devcafeine/buildbeacon/(list of files, cad)

Other CAD files:
hardware/cad/buildbeacon_tile_v1.0.scad
hardware/cad/buildbeacon_tile_v1.1.scad
hardware/cad/buildbeacon_tile_v1.2.scad
hardware/cad/buildbeacon_tile_v1.3.scad
hardware/cad/buildbeacon_tile_v1.4.scad
hardware/cad/buildbeacon_tile_v1.5.scad
hardware/cad/buildbeacon_tile_v1.6.scad
