devcafeine/buildbeacon/hardware/pcb/buildbeacon_master_v1.2.kicad_pcb

## KiCad design hardware/pcb/buildbeacon_master_v1.2.kicad_pcb (2026-11-11)

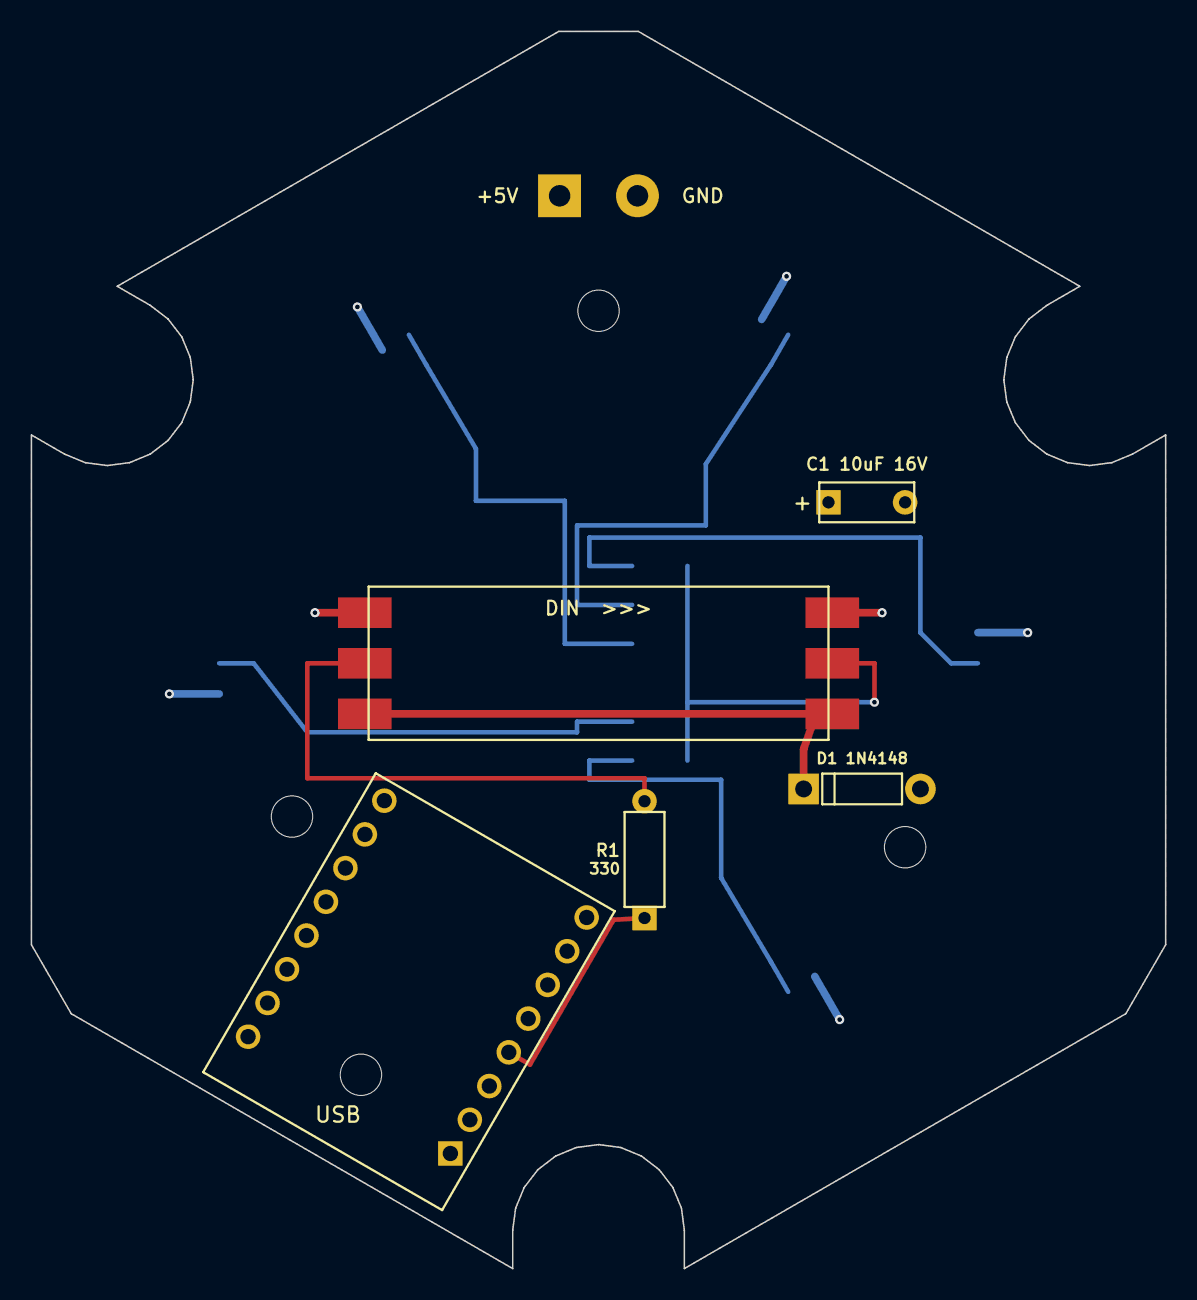
[picture p7: board buildbeacon_master_v1.2.kicad_pcb from above]

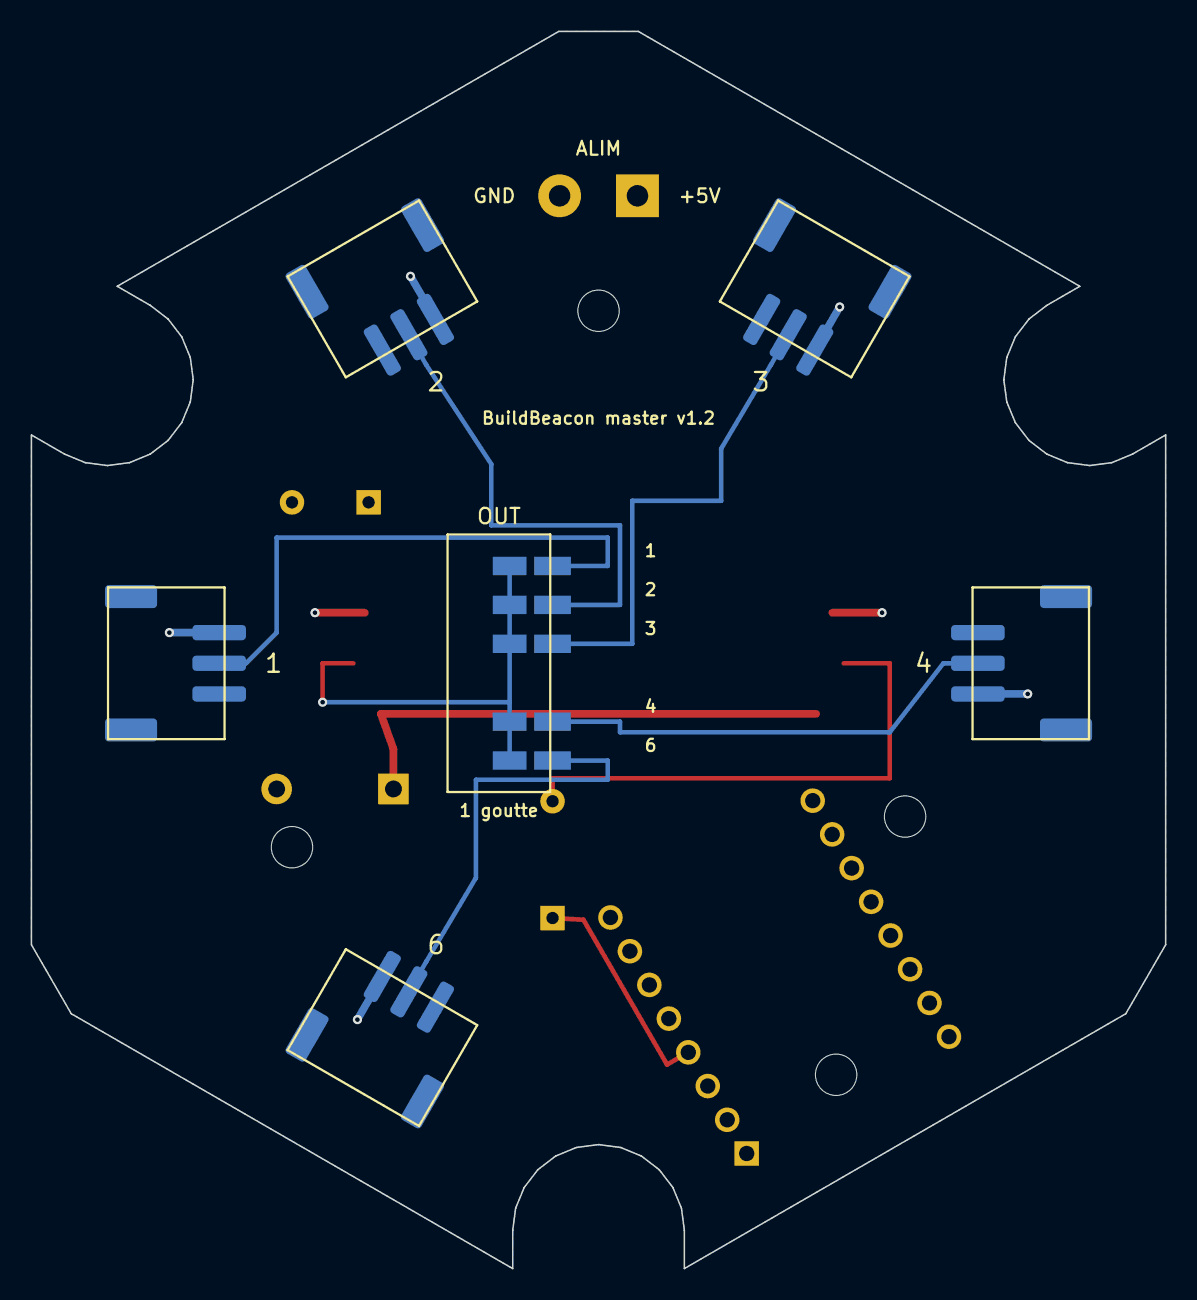
[picture p8: board buildbeacon_master_v1.2.kicad_pcb from below]

Board: 2 copper layers, 74.0 x 80.7 mm, 16 parts (6 on the bottom side), 11 nets.

Parts:
C1: 10uF; C_P5.00
D1: 1N4148/1N4007; D_DO-41_P7.62
H1, H2, H3, H4: M2.5; MountingHole_M2.5
J1, J2, J3, J4, J6: JST_PH_S3B-PH-SM4-TB_1x03-1MP_P2.00mm_Horizontal
J7: ALIM 5V; Alim_5V_P5.08
R1: 330; R_Axial_P7.62
RB1: Ruban_WS2812B_10mm
SW_OUT: SolderJumper_x5_P2.54
U1: ESP32-C3 SuperMini; ESP32-C3_SuperMini

Connections:
+5V: C1.1, D1.2, J1.1, J2.1, J3.1, J4.1, J6.1, J7.1, U1.L1
DO: RB1.OUT_D, SW_OUT.1B, SW_OUT.2B, SW_OUT.3B, SW_OUT.4B, SW_OUT.6B
GND: C1.2, J1.3, J1.MP, J2.3, J2.MP, J3.3, J3.MP, J4.3, J4.MP, J6.3, J6.MP, J7.2, RB1.IN_GND, RB1.OUT_GND, U1.L2
GPIO4: R1.1, U1.L4
S1_DIN: R1.2, RB1.IN_D
SIDE1: J1.2, SW_OUT.1S
SIDE2: J2.2, SW_OUT.2S
SIDE3: J3.2, SW_OUT.3S
SIDE4: J4.2, SW_OUT.4S
SIDE6: J6.2, SW_OUT.6S
VLED: D1.1, RB1.IN_5V, RB1.OUT_5V
