devcafeine/buildbeacon/hardware/pcb/buildbeacon_tuile_v1.2.kicad_pcb

## KiCad design hardware/pcb/buildbeacon_tuile_v1.2.kicad_pcb (2026-11-11)

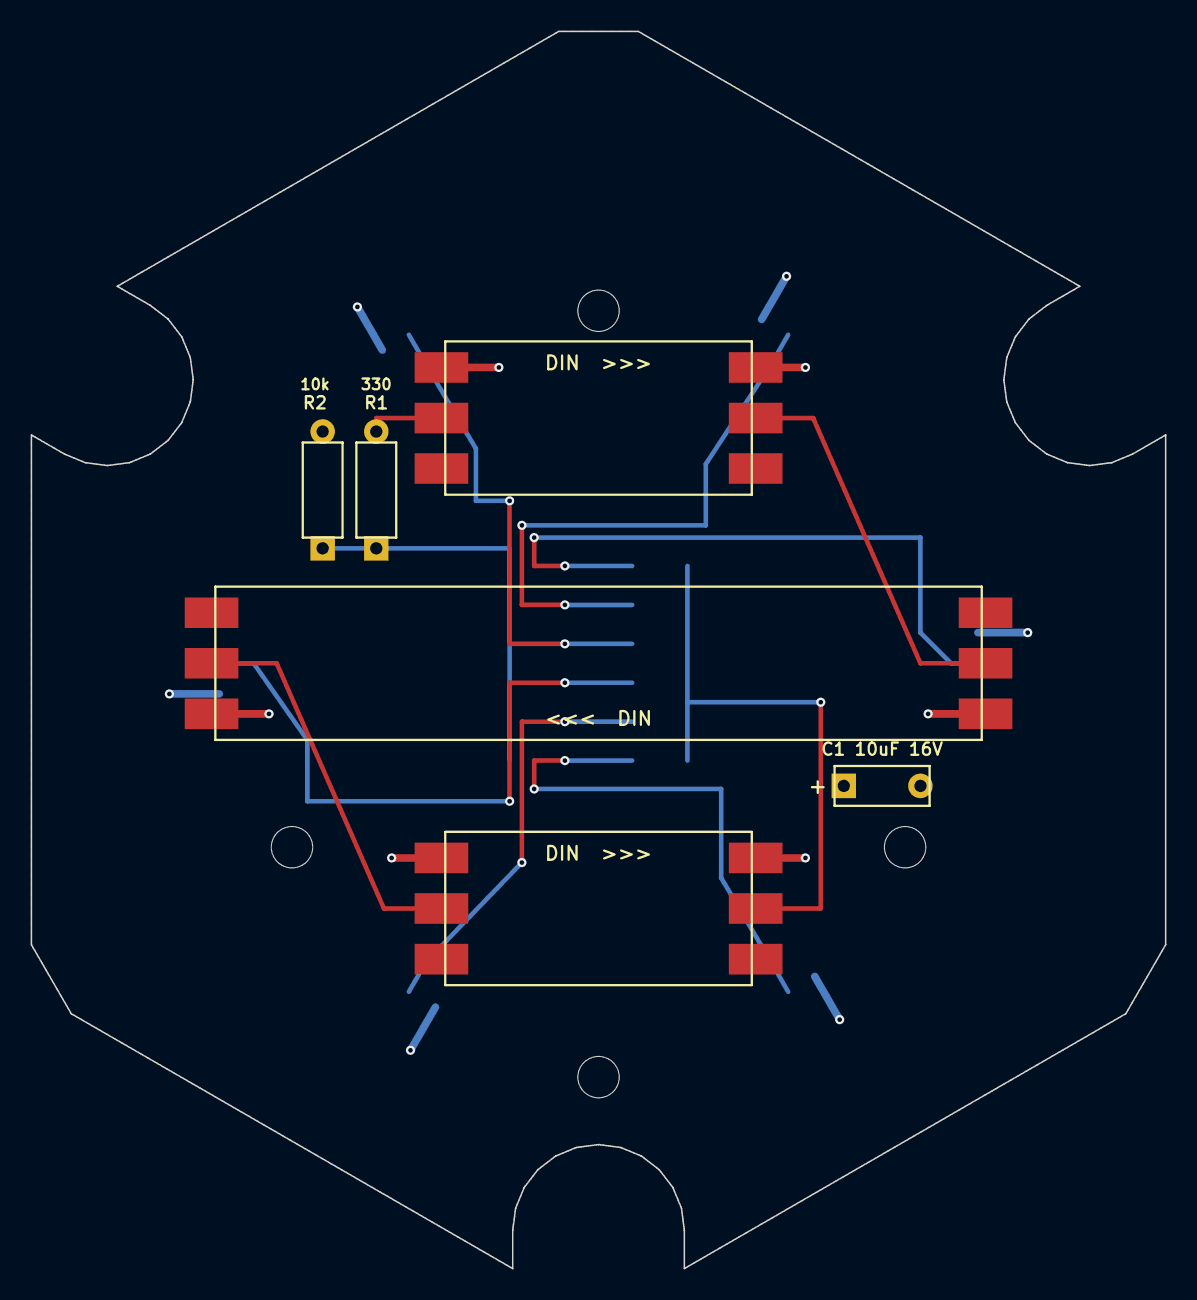
[picture p9: board buildbeacon_tuile_v1.2.kicad_pcb from above]

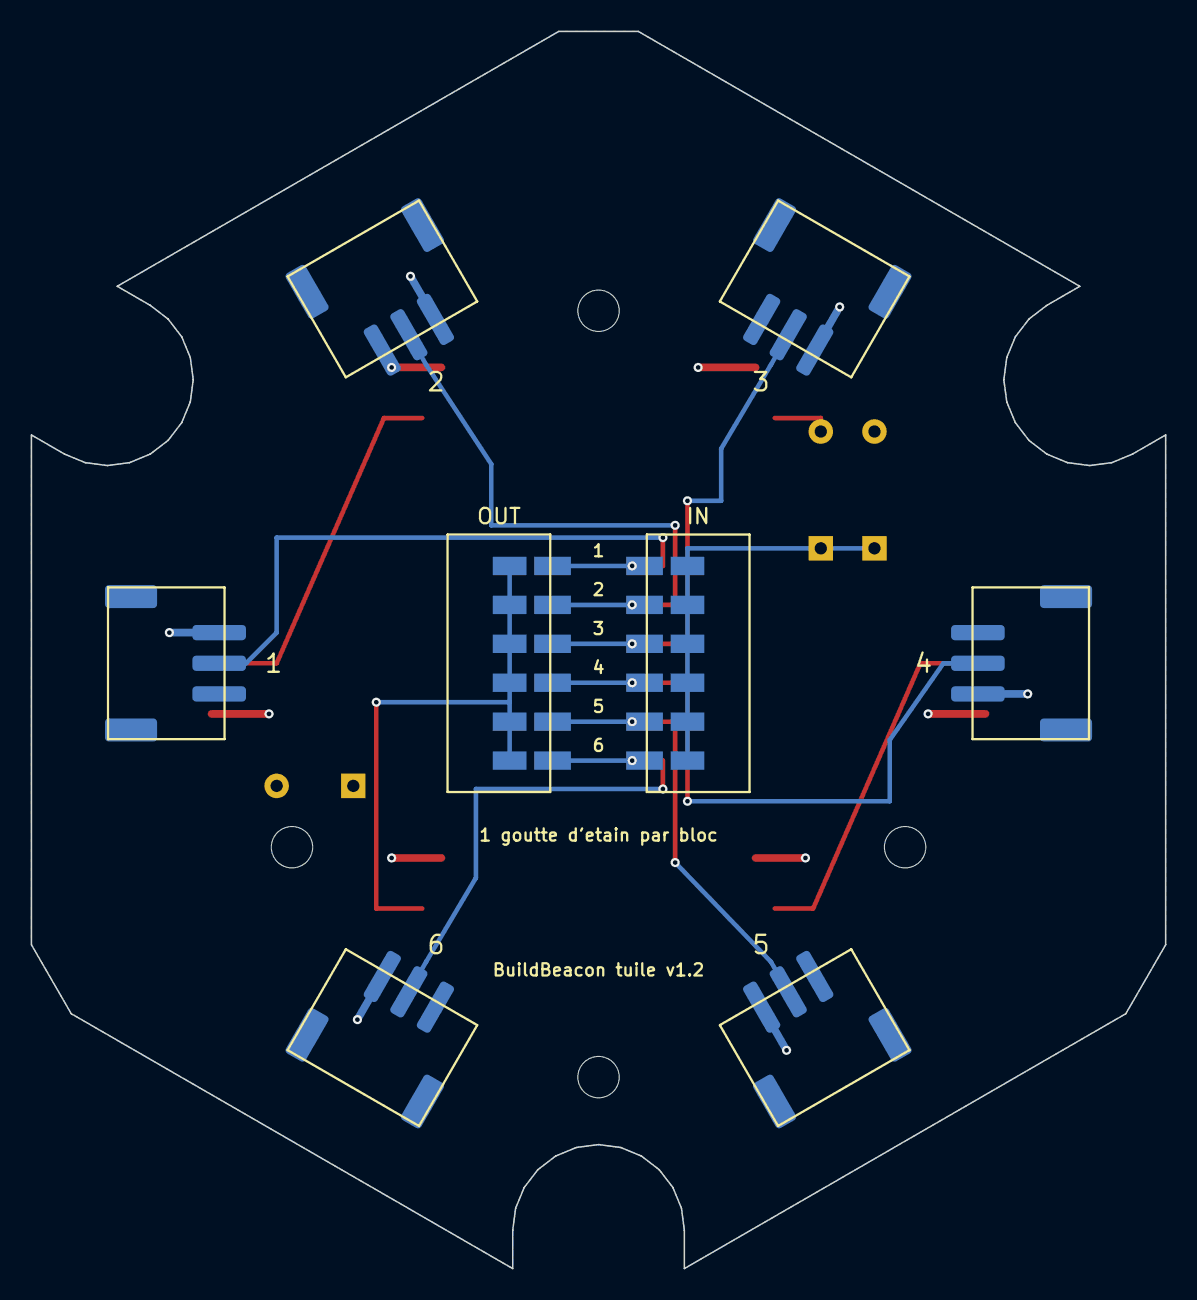
[picture p10: board buildbeacon_tuile_v1.2.kicad_pcb from below]

Board: 2 copper layers, 74.0 x 80.7 mm, 18 parts (8 on the bottom side), 13 nets.

Parts:
C1: 10uF; C_P5.00
H1, H2, H3, H4: M2.5; MountingHole_M2.5
J1, J2, J3, J4, J5, J6: JST_PH_S3B-PH-SM4-TB_1x03-1MP_P2.00mm_Horizontal
R1: 330; R_Axial_P7.62
R2: 10k; R_Axial_P7.62
RB1, RB2, RB3: Ruban_WS2812B_10mm
SW_IN: SolderJumper_x6_P2.54
SW_OUT: SolderJumper_x6_P2.54

Connections:
+5V: C1.1, J1.1, J2.1, J3.1, J4.1, J5.1, J6.1, RB1.IN_5V, RB1.OUT_5V, RB2.IN_5V, RB2.OUT_5V, RB3.IN_5V, RB3.OUT_5V
DI: R1.1, R2.1, SW_IN.1B, SW_IN.2B, SW_IN.3B, SW_IN.4B, SW_IN.5B, SW_IN.6B
DO: RB3.OUT_D, SW_OUT.1B, SW_OUT.2B, SW_OUT.3B, SW_OUT.4B, SW_OUT.5B, SW_OUT.6B
GND: C1.2, J1.3, J1.MP, J2.3, J2.MP, J3.3, J3.MP, J4.3, J4.MP, J5.3, J5.MP, J6.3, J6.MP, R2.2, RB1.IN_GND, RB1.OUT_GND, RB2.IN_GND, RB2.OUT_GND, RB3.IN_GND, RB3.OUT_GND
S1_DIN: R1.2, RB1.IN_D
S2_DIN: RB1.OUT_D, RB2.IN_D
S3_DIN: RB2.OUT_D, RB3.IN_D
SIDE1: J1.2, SW_IN.1S, SW_OUT.1S
SIDE2: J2.2, SW_IN.2S, SW_OUT.2S
SIDE3: J3.2, SW_IN.3S, SW_OUT.3S
SIDE4: J4.2, SW_IN.4S, SW_OUT.4S
SIDE5: J5.2, SW_IN.5S, SW_OUT.5S
SIDE6: J6.2, SW_IN.6S, SW_OUT.6S
