devcafeine/buildbeacon/(commit log)

2026-11-11 Premier dépôt public de BuildBeacon Hub
    - SDK des plugins, cœur (modèle, rendu des LED, registre), plugin GitHub Actions
    - sortie DDP vers WLED, simulateur (page web ou terminal), mire de mise en service
    - interfaces traduites (anglais, français)
    - README, guide de contribution et guide d'écriture d'un plugin (anglais, français)
    - CI GitHub Actions : format, analyse statique, tests
2026-11-11 Hub : programme principal et matériel pris en charge
    - bin/hub.dart (mise run hub) : lit data/config.json et .env, fait tourner les
    plugins, envoie l'image des LED à WLED en DDP, recharge la config à chaud
    (version invalide refusée), s'arrête proprement (Ctrl-C, SIGTERM)
    - vérification de WLED par son API JSON (nombre de LED, luminosité)
    - avertissement si le quota GitHub sans jeton (60 requêtes/heure) est dépassé
    - config.example.json : dépôts publics BuildBeacon, WLED et mise, sans jeton
    - documentation : lancer le Hub, matériel sur lequel il tourne (README EN/FR),
    mise run hub (CONTRIBUTING), essayer un plugin (guide)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
2026-11-11 Add hardware: 3D models, boards and EN/FR assembly guide
    - hardware/cad: parametric OpenSCAD model of the tiles (v1.0)
    - hardware/pcb: KiCad boards for the project tile and the master tile
    (v1.0), generator script and PNG preview script
    - hardware/README.md / README.fr.md: assembly guide (components,
    jumpers, power, printing, WLED)
    - hardware/LICENSE: CERN-OHL-P-2.0
    - README, CONTRIBUTING, .gitignore: links to hardware/
    Claude-Session: https://claude.ai/code/session_01CGE87WsPvkfgfKcZK5eo72
    [buildbeacon_master_v1.0.kicad_pcb, buildbeacon_tile_v1.0.scad, buildbeacon_tuile_v1.0.kicad_pcb]
2026-11-11 Hardware: v1.2 boards and KiCad 3D renders
    - KiCad boards renamed to v1.2 (identical to the boards ordered),
    generator gen_buildbeacon_pcb_v1.2.py
    - KiCad 3D renders (front / back) replace the generated previews;
    render_pcb_v1.0.py removed
    - hardware README EN/FR at v1.1: renders table, v1.2 references
    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
    [buildbeacon_master_v1.0.kicad_pcb, buildbeacon_master_v1.2.kicad_pcb, buildbeacon_tile_v1.1.scad, buildbeacon_tuile_v1.0.kicad_pcb, buildbeacon_tuile_v1.2.kicad_pcb]
2026-11-11 Hardware: shopping list and tools in the assembly guide
    - hardware README EN/FR v1.2: shopping list for 1 master + N project
    tiles (with an N = 4 example), notes for building without boards
    - list of the tools needed for the build
2026-11-11 API REST du Hub (shelf) : configuration, plugins, état en direct, identification
    - Routes /api : health, config (GET / PUT : validée, enregistrée de façon
    atomique, appliquée à chaud), config/validate, plugins (secrets : seulement
    « configured »), state, events (Server-Sent Events), frame,
    tiles/<id>/identify, wled/check.
    - Écritures en JSON obligatoire (protection CSRF), jeton facultatif
    BB_API_TOKEN (Authorization: Bearer) ; messages traduits {"en","fr"}.
    - HubService : validation, enregistrement et rechargement du fichier (une
    configuration identique, comme celle que l'API vient d'écrire, est ignorée).
    - bin/hub.dart : --port (BB_PORT, 8080), --listen (BB_LISTEN, 0.0.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
2026-11-11 Interface web (Flutter Web) servie par le Hub
    - hub/ui (buildbeacon_ui, dans l'espace de travail) : le mur dessiné à sa
    vraie place, LED en direct et animées ; panneaux Tuile (nom, identifiant,
    zones : source au formulaire généré depuis le plugin, mode d'affichage,
    seuils, jauge, état en direct), Chaîne (ordre de câblage par glisser, LED,
    nombre de LED de WLED) et Réglages (WLED, luminosité, scrutation, couleurs,
    secrets) ; ajout par « + », déplacement et échange par glisser.
    - Brouillon prévisualisé dans le navigateur (FrameRenderer du cœur + états
    des sources), validé par le Hub pendant la saisie, appliqué à
    l'enregistrement ; bandeau si la configuration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
2026-11-12 Premier démarrage sans config.json ; démarrage sans attendre WLED
    - Fichier absent : le Hub le crée avec la tuile master seule (dossier
    compris) et invite à régler les tuiles depuis l'interface web ; un fichier
    présent mais invalide n'est jamais remplacé (readOrCreateConfigFile).
    - Démarrage et enregistrement n'attendent plus WLED : le nom DDP se résout en
    arrière-plan (une adresse IP sert tout de suite), la vérification de WLED
    aussi (résultat par le flux en direct). Sans WLED sur le réseau, l'API
    répond en 0,4 s au lieu de 8 s, et un enregistrement aussitôt.
    - Documentation : README (lancer le Hub, simulateur réglé depuis
    l'interface, mise en service avec l'int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
2026-11-12 Image Docker du Hub et de son interface ; mDNS sans démon
    - hub/Dockerfile : tout compilé sur la machine de construction, sans
    émulation (interface Flutter Web, Hub en compilation croisée pour x86-64,
    arm64, ARMv7) ; image finale scratch d'environ 40 Mo, utilisateur non
    root, config.json dans /data, interface servie par le Hub.
    - docker-compose.yml : réseau de l'hôte (DDP, mDNS), .env facultatif, volume
    buildbeacon-data, heure locale.
    - Résolution du nom de WLED (host_resolver.dart), partagée par la sortie DDP
    et l'API JSON de WLED : pour un nom .local inconnu du système (conteneur),
    requête mDNS ponctuelle (RFC 6762, § 5.1), sans écouter le port 5353.
    - Essai de l'im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
2026-11-12 Publish the Docker image on GHCR
    - New publish workflow: on every merge into main, the image is built for
    linux/amd64, linux/arm64 and linux/arm/v7 (cross-compiled, no emulation)
    and pushed to ghcr.io/devcafeine/buildbeacon-hub as latest and sha-…;
    a version tag vX.Y.Z also publishes X.Y.Z and X.Y. Only GITHUB_TOKEN
    is used (packages: write).
    - docker-compose.yml uses the published image by default; `--build` still
    builds it from hub/. Tried with the compose file alone (no hub/ folder).
    - README: install with two files (docker-compose.yml and .env), no clone;
    update with docker compose pull; version tags; building from sources.
    - CONTRIBUTING: publishing a version (maintainers)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
2026-11-12 Web interface: 3D printing tab (OpenSCAD parameter sets)
    The interface knows the wall (tiles, names, places): the new tab turns it
    into what to print with the parametric model of hardware/cad.
    - PrintPlan: a shell per tile (label = tile name; master tile with the
    logo), the master back plate, one back plate for the project tiles to
    print N times (they are identical: the name is only on the shell), and
    the dog bones joining the back plates, one per shared side.
    - Download of buildbeacon_tile_v1.1.json, OpenSCAD parameter sets that the
    Customizer loads next to the model, and the commands rendering every
    part (openscad -p … -P <set> -o <set>.stl).
    - Contract test: the model still e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
2026-11-12 Hardware README: parameter sets from the web interface
    The 3D models section (EN/FR) now points to the 3D printing tab of the
    web interface: parts of the wall, download of buildbeacon_tile_v1.1.json
    (one OpenSCAD parameter set per part, loaded by the Customizer next to
    the model) and the commands that render every part.
2026-11-12 OpenSCAD model v1.2: comments in English
    Hardware is now managed in this repository: the parametric model follows
    the rule of the code, comments in English.
    - hardware/cad/buildbeacon_tile_v1.2.scad (renamed from v1.1, the version
    is in the file name): 425 comment lines, Customizer section names and
    parameter descriptions, and the echo warnings in English; bb_version
    1.2. Widget lists and code unchanged.
    - Checked with OpenSCAD 2021.01: 24 cases covering every part and the
    main options (master, styles, PCB, orientation, plate styles, screws,
    second line) give the same evaluated CSG tree with v1.1 and v1.2, and a
    different one from case to case.
    - Web interface export and its tes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
    [buildbeacon_tile_v1.2.scad]
2026-11-12 OpenSCAD model v1.3: the boards have 4 mounting holes
    Both boards have 4 M2.5 mounting holes (pcb_holes_front, and 4 mounting
    holes in each KiCad file), as the hardware guide already says (4 inserts
    and 4 screws per board). The model said otherwise in two places:
    - comment "PCB: 3 spacers" → 4 spacers (the 4 holes of the board);
    - console message "3 M2.5 x 6 self-tapping screws" → 4 M2.5 x 6 screws,
    in brass inserts or self-tapping depending on pcb_fix (the default is
    inserts).
    Geometry unchanged (same evaluated CSG as v1.2). Web interface export,
    its tests and the hardware README follow the new file name.
    [buildbeacon_tile_v1.3.scad]
2026-11-12 README: 3D printing section and new screenshots
    - New "3D printing" section (EN/FR) under "Run the Hub": the parts of the
    wall (shells, master and shared project back plates, dog bones), the
    parameter sets file for the OpenSCAD Customizer, the commands that render
    every part, and the link_test tip.
    - Screenshots of the interface retaken with the four tabs
    (web-ui_*_v1.1.png), plus one of the 3D printing tab (print-tab_*_v1.0.png).
2026-11-12 OpenSCAD model v1.4: clean USB slot in the stand, closing comment
    Stand (part = stand): the USB passage of the master tile was a box tilted
    by 30 degrees. It left a knife-edge sliver on the top next to the master
    pocket, a slanted notch in the back face and a cut under the left end;
    and it started 12.5 mm from the front of the tile, where the USB window of
    the strip mounting is, so with the boards (led_mount = "pcb", window near
    the front) the plug hit the stand.
    It is now a straight slot with vertical walls, open at the top, from the
    USB window of the tile (wherever it is for the mounting) to the back of
    the stand, wide enough for the plug (stand_usb_plug, 15 mm) above a
    2 mm floor (stand_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
    [buildbeacon_tile_v1.4.scad]
2026-11-12 OpenSCAD model v1.5: notches centered on each side (comment)
    The comment above notch_shift() said that with the PCB, the connectors of
    the left and right sides are raised by 8 mm, and so are their notches.
    The v1.2 boards have their JST connectors centered on each side (board
    generator), and notch_shift() keeps every notch centered: the comment
    came from an earlier board. It now says so; the function stays, to move
    the notch of a side if a future board moves its connector.
    Comment only: no geometry change. The web interface export, its tests and
    the hardware README follow the new file name.
    [buildbeacon_tile_v1.5.scad]
2026-11-12 OpenSCAD model v1.6: why the master board's hole is 2 mm higher
    The bottom-left mounting hole of the master board is at (-20, -10), 2 mm
    higher than on the project boards (-20, -12). Nothing explained it, and
    "aligning" it would bring the screw head against the ESP32 module: at
    (-20, -12) the hole center is 2.3 mm from the module edge, leaving
    0.07 mm for an M2.5 head; at (-20, -10), 3.3 mm, leaving 1.1 mm.
    A comment next to pcb_holes_front now says so, and that the 4th hole of
    the master is under the module, in the gap left by the pin header spacer.
    the hardware README follow the new file name.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
    [buildbeacon_tile_v1.6.scad]
2026-11-12 mise run hub builds the web interface first, when its sources changed
    The Hub serves hub/ui/build/web as it finds it: a build made before a
    change kept being served. The 3D printing tab offered the v1.4 parameter
    sets while the model was v1.6, because the build was older than the code.
    - hub/tool/ui_build.sh builds the interface only when a source is newer
    than a stamp written after each successful build (code, ARB
    translations, web files, assets, core and SDK; not the generated
    translations). The stamp is needed: Flutter does not rewrite an output
    whose content did not change, so its date cannot be used.
    - mise: ui-build runs this script; hub depends on ui-build.
    - README, CONTRIBU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
2026-11-13 OpenSCAD model v1.7: tile-to-tile magnets in the back plates, test piece (#22)
    One 6x3 mm magnet per side, standing on edge in a boss of the back plate,
    under the PCB. The boss goes into a recess on the inside of the shell wall:
    only a 0.6 mm skin of each shell is left between the magnets of two
    neighbors. The magnets sit at the 3 corners without a closing column; their
    offset along the side alternates so that the magnets of two neighbors face
    each other, and pockets are engraved "+" / "-" for the polarity.
    Off by default (link_magnets = false) while it is being tested: default
    renders are identical to v1.6. part = magnet_test cuts the matching pieces
    of two neighboring tiles from the real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
    [buildbeacon_tile_v1.7.scad]
